CaterPullUp/CaterPullUp/Électrique/schema_electrique (1).png

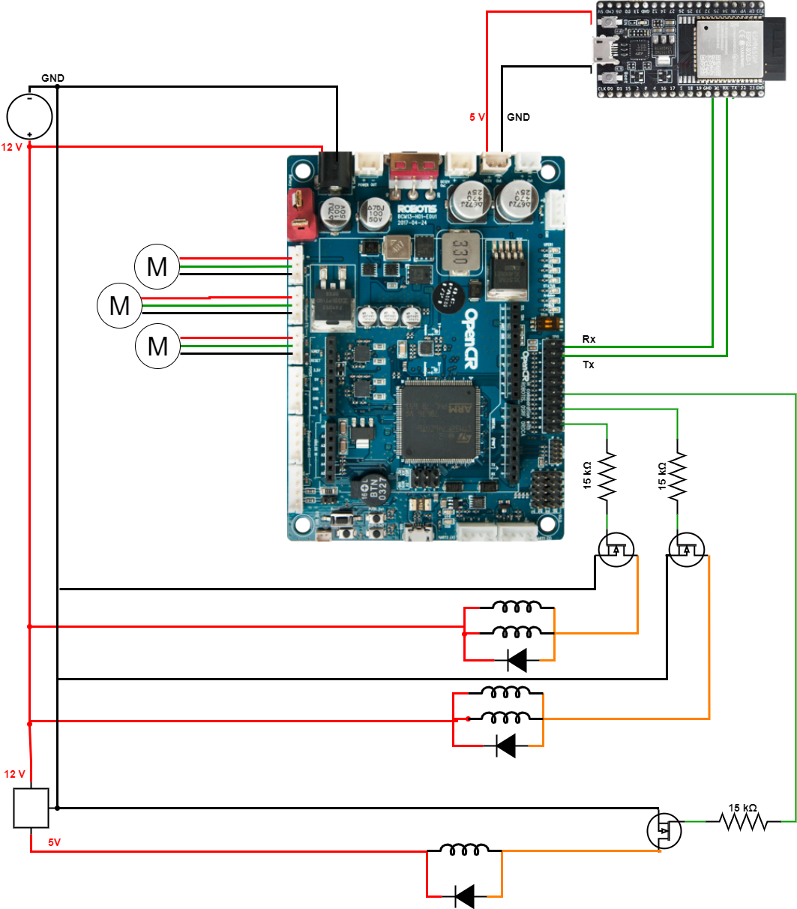
Électrique/schema_electrique (1).png
