CaterPullUp/CaterPullUp/Code/GUI/README.md

# Interface graphique

Le GUI permet d'envoyer des commandes à partir de l'interface jusqu'au robot et ce grâce à une connexion sans fil Bluetooth. Il est possible dans   le GUI d'accéder à deux fenêtres de contrôle distinctes.Une seule des deux fenêtre peut être ouverte à la fois, rnedant plus prévisible et sécuritaire l'utilisation du robot. La fenêtre de contrôle automatique du robot permet de faire avancer le robot sans arrêt, d'une distance entrée, d'une séquence à la fois, la séquence étant toutes les étapes permettant de faire avancer le robot d'une seule longueur de patte, d'une étape de la séquence à la fois et d'arrêter le mouvement du robot. La fenêtre de contrôle manuel du robot permet de bouger individuellement les sections du robot, comprenant la patte avant, le corps avec l'actuateur linéaire et la patte arrière, ainsi que d'activer et désactiver les électroaimants du robot par sections. Des fenêtres d'erreur apparaissent lorsque le robot, en mode manuel, effectuerait une action dommageable pour le robot à la suite d'une commande. Une telle action serait par exemple de déplacer la patte avant du robot alors que ses électroaimants sont activés, pouvant ainsi potentillement briser le robot physiquement. L'interface utilisateur final est le fichier CPU_GUI_FINAL.py.

## Fenêtre pour l'utilisation manuelle

Les différentes sections et composantes du robot peuvent être contrôlées individuellement à l'aide de la fenêtre d'utilisation manuelle.
controle_manuel

Les pattes et l'actuateur linéaire peuvent être déplacés individuellement et les électroaimants peuvent être activés et désactivés par section, le tout de façon sécuritaire en empêchant des configurations qui pourraient endommager le robot et ses composantes. La représentation visuelle du robot permet de voir si les pattes et l'actuateur sont séparément en extension ou rétractés et quels électroaimants sont activés ou désactivés.
D'abord la patte arrière rétractée avec les électroaimants activés ou désactivés:
<p align="justify">
  
  
  
<p>
 Puis la patte arrière en extension avec les électroaimants activés ou désactivés:
<p align="justify">  
  
  
<p>
Des boîtes de message d'erreurs apparaissent lorsque l'utilisateur appuie sur un bouton menant à une configuration interdite, par soucis de ne pas endommager le robot. Une brève description de l'erreur est affichée et la fenêtre du GUI est inaccessible jusqu'à ce que l'utilisateur reconnaisse l'erreur en appuyant su le bouton 'OK'. Dans ce cas-ci le bouton Bouger patte avant est appuyé alors que les électroaimants de la patte avant sont activés:
  
errerur_bouger

## Fenêtre pour l'utilisation automatique
La fenêtre automatique permet de contrôler le robot pour qu'il accomplisse différentes actions en lien direct avec le déplacement linéaire du robot sur la surface métallique. Les options de contrôlent incluent le déplacement du robot sans arrêt avec le bouton Avancer, le déplacement une séquence à la fois avec le bouton Séquence, le déplacement une étape de la séquence à la fois avec le bouton Étapes, le déplacement en entrant une distance puis en appuyant sur le bouton Avancer et arrêter le robot à tout moment avec le bouton ARRÊT.
controle_automatique
