CaterPullUp/CaterPullUp/Code/doc/Diagramme_classes.png

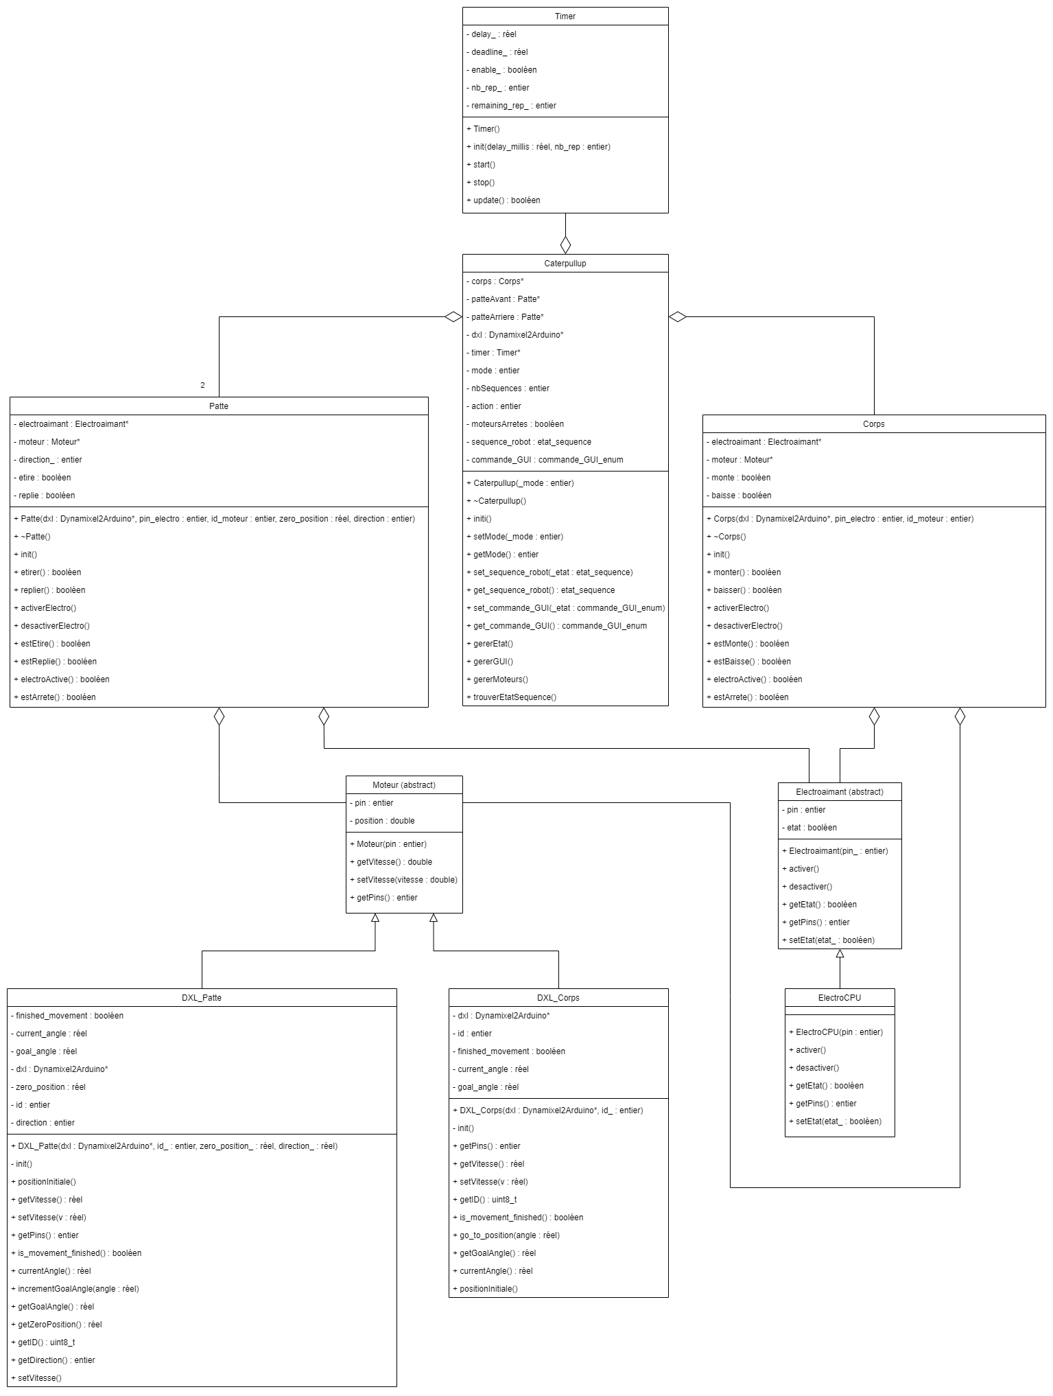
Code/doc/Diagramme_classes.png
