CaterPullUp/CaterPullUp/Code/doc/Diagramme_classes_simplifié.png

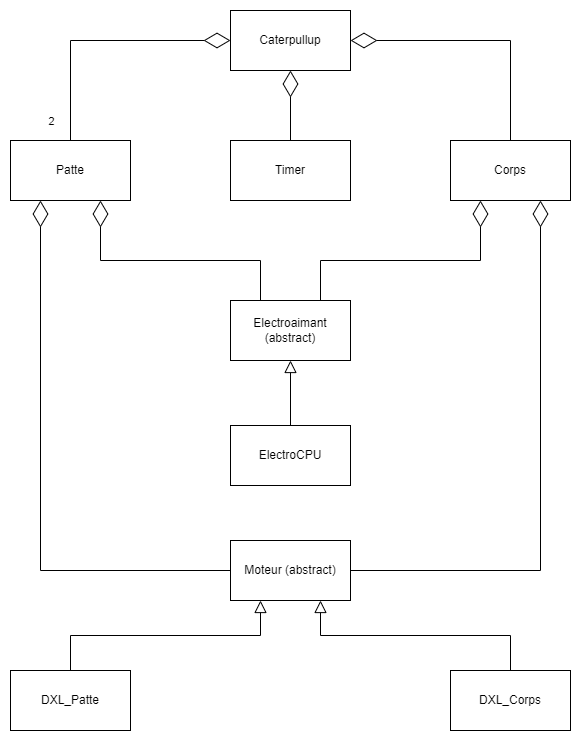
Code/doc/Diagramme_classes_simplifié.png
