CaterPullUp/CaterPullUp/Code/doc/Diagramme_etats.png

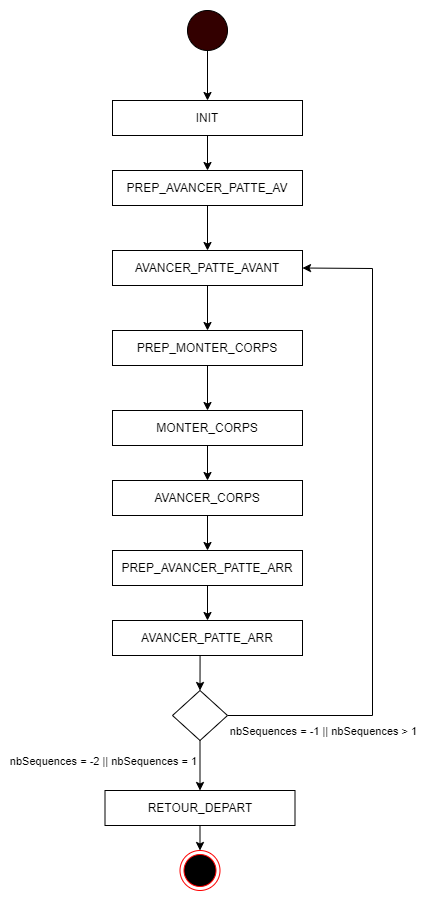
Code/doc/Diagramme_etats.png
