CaterPullUp/CaterPullUp/Électrique/protoboard2.png

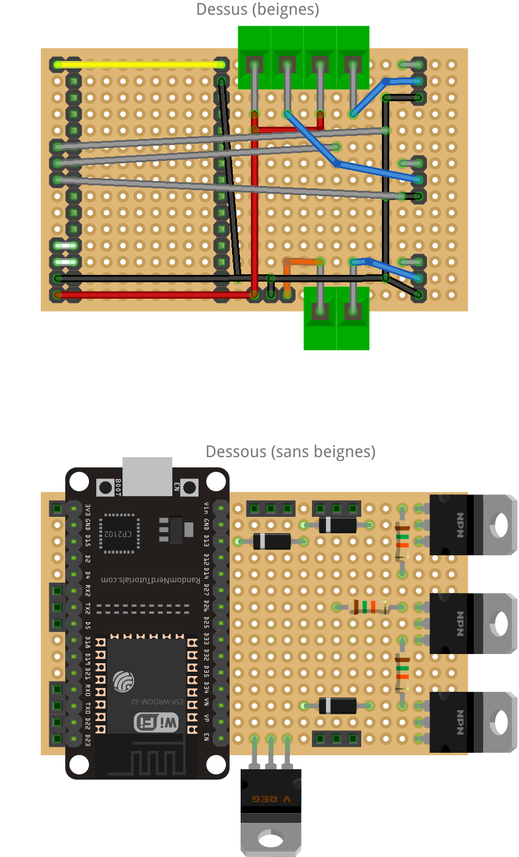
Électrique/protoboard2.png
