CaterPullUp/CaterPullUp/Électrique/schema_architecture (1).png

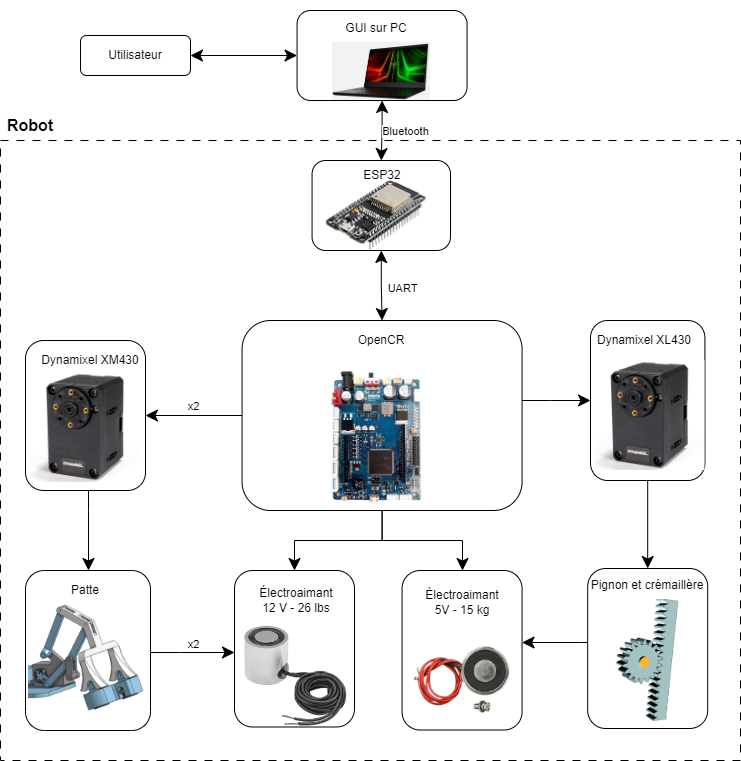
Électrique/schema_architecture (1).png
