CaterPullUp/CaterPullUp/Code/Embarqué/OpenCR/Corps.cpp

/***
 * @author Étienne Germain
 * @file Corps.cpp
 * @date 17 janvier 2023
***/

#include "Corps.h"

Corps::Corps(Dynamixel2Arduino* dxl, int pin_electro, int id_moteur)
{
    moteur = new DXL_Corps(dxl, id_moteur);
    electroaimant = new ElectroCPU(pin_electro);
    monte = false;
    baisse = false;
}

Corps::~Corps()
{
    delete moteur;
    delete electroaimant;
}

void Corps::init()
{
    desactiverElectro();
    ((DXL_Corps *)moteur)->positionInitiale();

    monte = true;
    baisse = false;
}

bool Corps::monter()
{
    if(monte)
    {
        return true;
    }

    if(baisse)
    {
        ((DXL_Corps *)moteur)->go_to_position(ANGLE_MONTER);
        baisse = false;

        return false;
    }

    if(estArrete())
    {
        monte = true;
        return true;
    }

    return false;
}

bool Corps::baisser()
{
    if(baisse)
    {
        return true;
    }

    if(monte)
    {
        DEBUG_SERIAL.println("Start baisse corps");
        ((DXL_Corps *)moteur)->go_to_position(ANGLE_BAISSER);
        monte = false;

        return false;
    }

    if(estArrete())
    {
        DEBUG_SERIAL.println("End baisse corps");
        baisse = true;
        return true;
    }

    return false;
}

bool Corps::rapprocher()
{
    ((DXL_Corps *)moteur)->go_to_position(ANGLE_RAPPROCHE);
    DEBUG_SERIAL.println("Rapproche corps");
    if(estArrete())
    {
        DEBUG_SERIAL.println("End rapproche corps");
        return true;
    }

    return false;
}

void Corps::activerElectro()
{
    electroaimant->activer();
}

void Corps::desactiverElectro()
{
    electroaimant->desactiver();
}

bool Corps::estMonte()
{
    return monte;
}

bool Corps::estBaisse()
{
    return baisse;
}

bool Corps::electroActive()
{
    return electroaimant->getEtat();
}

bool Corps::estArrete()
{
    return ((DXL_Corps *)moteur)->is_movement_finished();
}
