CaterPullUp/CaterPullUp/(commit log)

2023-01-23 hierarchie de code, esp32, opencr
2023-01-30 interface de communication serie
2023-02-21 Modifier/Créer les descriptions des systèmes
    Création d'un sous-section par système avec courte description et image
2023-02-22 GUI V1
    Le GUI du mode automatique et le GUI du mode manuel sont tous les deux individuellement fonctionnels, bien qu'ils ne commandent pas d'actions pour l'instant. Une version non complète d'un GUI regroupant les deux modes est aussi introduit.
2023-03-15 Machine a état de la séquence, enums
2023-03-22 CPU GUI MW avec 2 fenêtres fonctionnelles
    Mise à jour du fichier python avec les deux fenêtre intechangeables. Les fenêtre sont visuellement complétées et les différents boutons sont fonctionnels, mais n'envoient pas encore de commandes.
2023-03-28 Gestion des erreurs en mode manuel
    Ajout de boîtes de messages lorsque des configurations impossibles veulent être atteintes dans le GUI en mode manuel. Ces boîtes de messages indiquent quel est le problème et ce qu'il peut être fait pour y remédier. Par exemple, si une patte veut être déplacée alors que ses électroaimants sont activés, le message indiquera qu'il faut d'abord désactiver les électroaimants pour pouvoir faire un tel mouvement. Création préliminaire d'un bloc message binaire pour l'envoi des commandes vers le robot.
2023-03-29 Description du mode manuel
    Une description préliminaire est ajoutée pour l'utilisation du mode manuel pour contôler les composantes du robot individuellement. Des photos devront être ajoutées et la description devra être complétée.
2023-03-29 Faire bouger les moteurs a leur position initiales en partant le code et gestions des erreurs de merge
2023-03-29 Transfert de séquence et étapes vers automatique
    Les commandes de déplacement par séquence et par étapes sont transférés vers le mode automatique pour faciliter la gestion de l'affichage de l'état du robot en tout temps dans la fenêtre de contrôle manuel. La barre de progression est aussi transférée vers le mode automatique et le bouton d'arrêt est enlevé du mode manuel puisqu'il n'est plus nécessaire.
2023-03-30 Ajouter des fichier supplementaire que j'ai oublier de push
2023-03-30 Photos manuel et début automatique
    La documentation inclut désormais des photos représentant le mode de contrôle manuel et un début de documentation sur le mode de contrôle automatique
2023-04-02 Classes DXL, correction de bugs
    [Caterpullup.cpp, Caterpullup.h, Corps.cpp, Corps.h, DXL_Corps.cpp, DXL_Corps.h, DXL_Patte.cpp, DXL_Patte.h]
2023-04-03 le robot fait une sequence sans la cremaillere
2023-04-05 ajout timer et tests sequence
2023-04-07 Ajout timers
2023-04-11 Ajout des envois de message dans les fonctions
    Ajout des envois de message dans les fonctions et modification de la forme du bloc message. Correction d'un problème dans la fonction de parité
2023-04-13 Mise à jour de la doc avec les avancements
    Mise à jour du texte et des images en fonction des changements apportés au code
2023-04-13 Reconnect et changements dans automatique
    Ajout de la fonction pour reconnecter le GUI à la carte ESP32 si le ESP32 se déconnecte. Changements dans le mode automatique pour simplifier l'utilisation et rendre plus centralisée la fonction d'avancer. Changements divers sur la mise en page du GUI
2023-04-13 Ajout de rapprocher corps, vitesse aug, timer dim
2023-04-13 corrections et début réception
    Changements des num d'envoi d'états pour correspondre aux nouveaux numéros d'états. Amélioration de certaines limites (min distance et basculer vers automatique)
2023-04-15 Regler erreur de log file vide
2023-04-15 build sur arduino ide fonctionel et commentaire
2023-04-17 add modification to be able to run on arduino ide
2023-04-17 Explications en commentaires des sections
    Explications des sections de connexion bluetooth, de configuration de la fenêtre et des variables utilisées pour la gestion du GUI
2023-04-17 Enelver des comentaires et clean le code
2023-04-17 Mis a jour Readme.md OpenCR
    Ajout des description des fichiers utiliser dans l'onglet OpenCR
